deJcob/STM32_PBLV5/README.md

# STM32_PBLV5

In stm32_conn/Output there are electrical schematics of project.
