deJcob/STM32_PBLV5/stm32_conn/output/stm32_conn.pdf

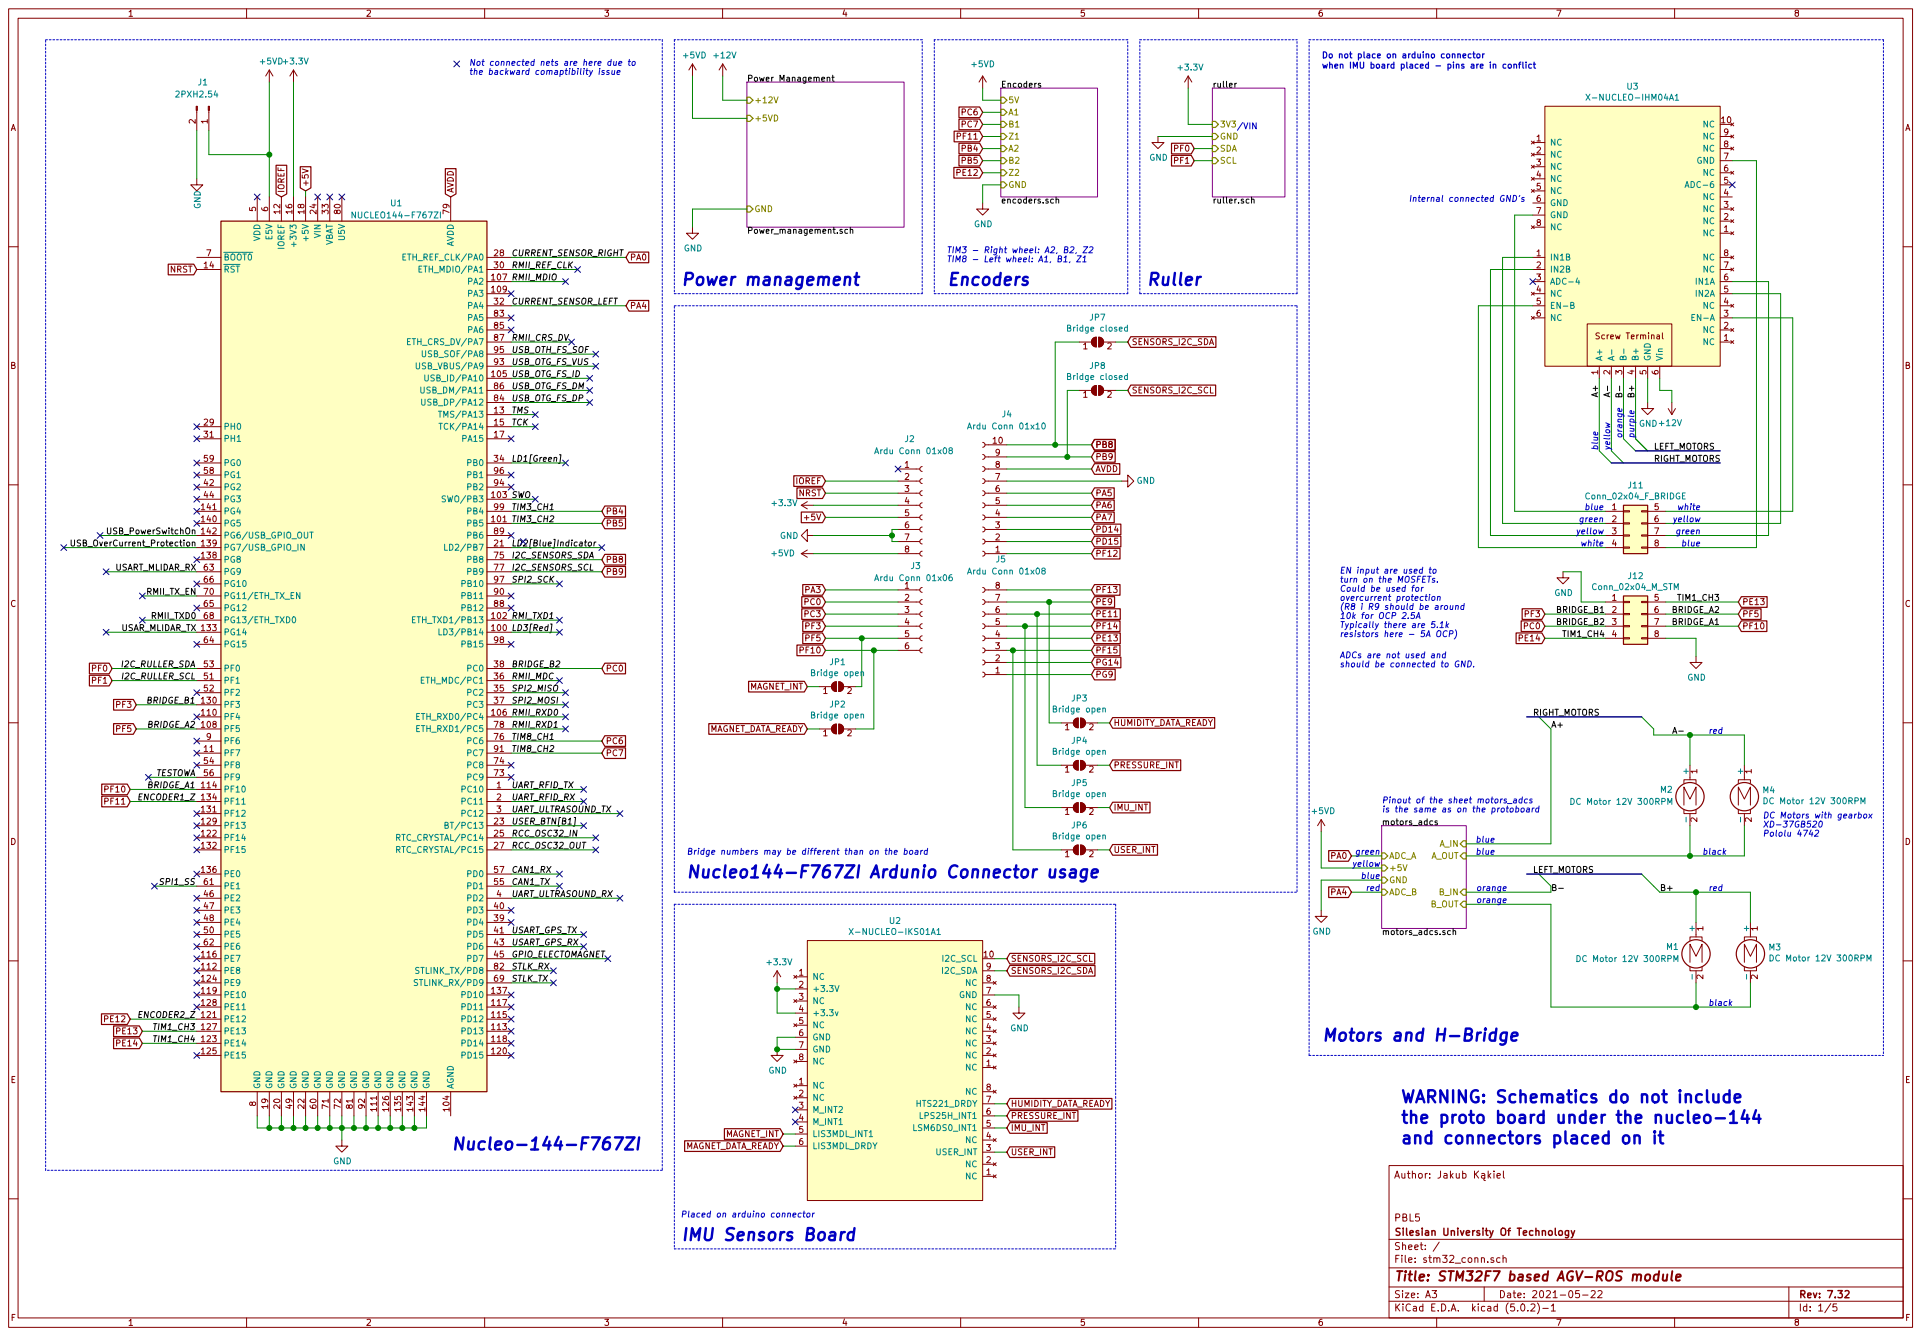
[picture p1: page 1]

the backward comaptibility issue

TIM3 - Right wheel: A2, B2, Z2 TIM8 - Left wheel: A1, B1, Z1
Encoders

turn on the MOSFETs. Could be used for overcurrent protection

(R8 i R9 should be around 10k for OCP 2.5A
Typically there are 5.1k
resistors here - 5A OCP) ADCs are not used and

Pinout of the sheet motors_adcs

DC Motors with gearbox XD-37GB520 Pololu 4742 IMU Sensors Board

Bridge numbers may be different than on the board

the proto board under the nucleo-144
and connectors placed on it

File: stm32_conn.sch Sheet: / Silesian University Of Technology PBL5 Author: Jakub Kkiel

Placed on arduino connector

Id: 1/5 Title: STM32F7 based AGV-ROS module

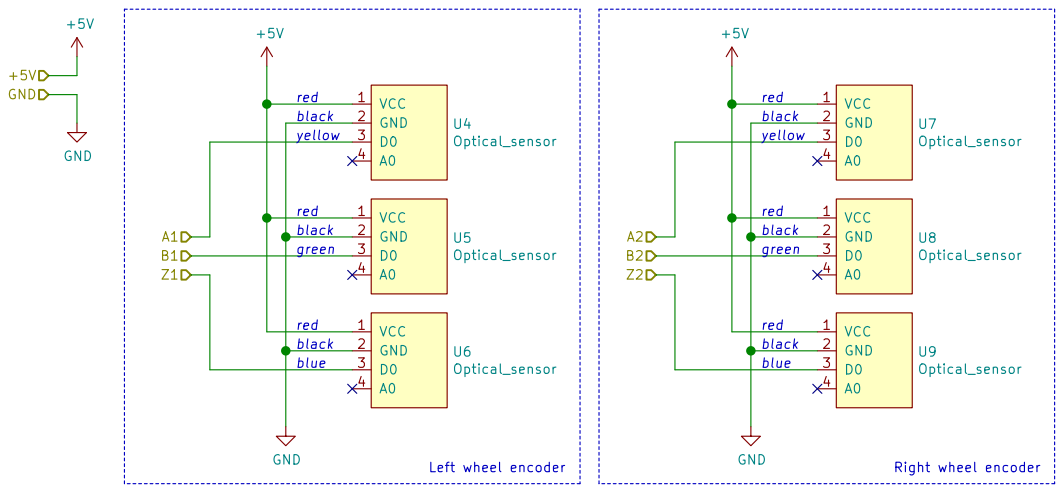
[picture p2: page 2]

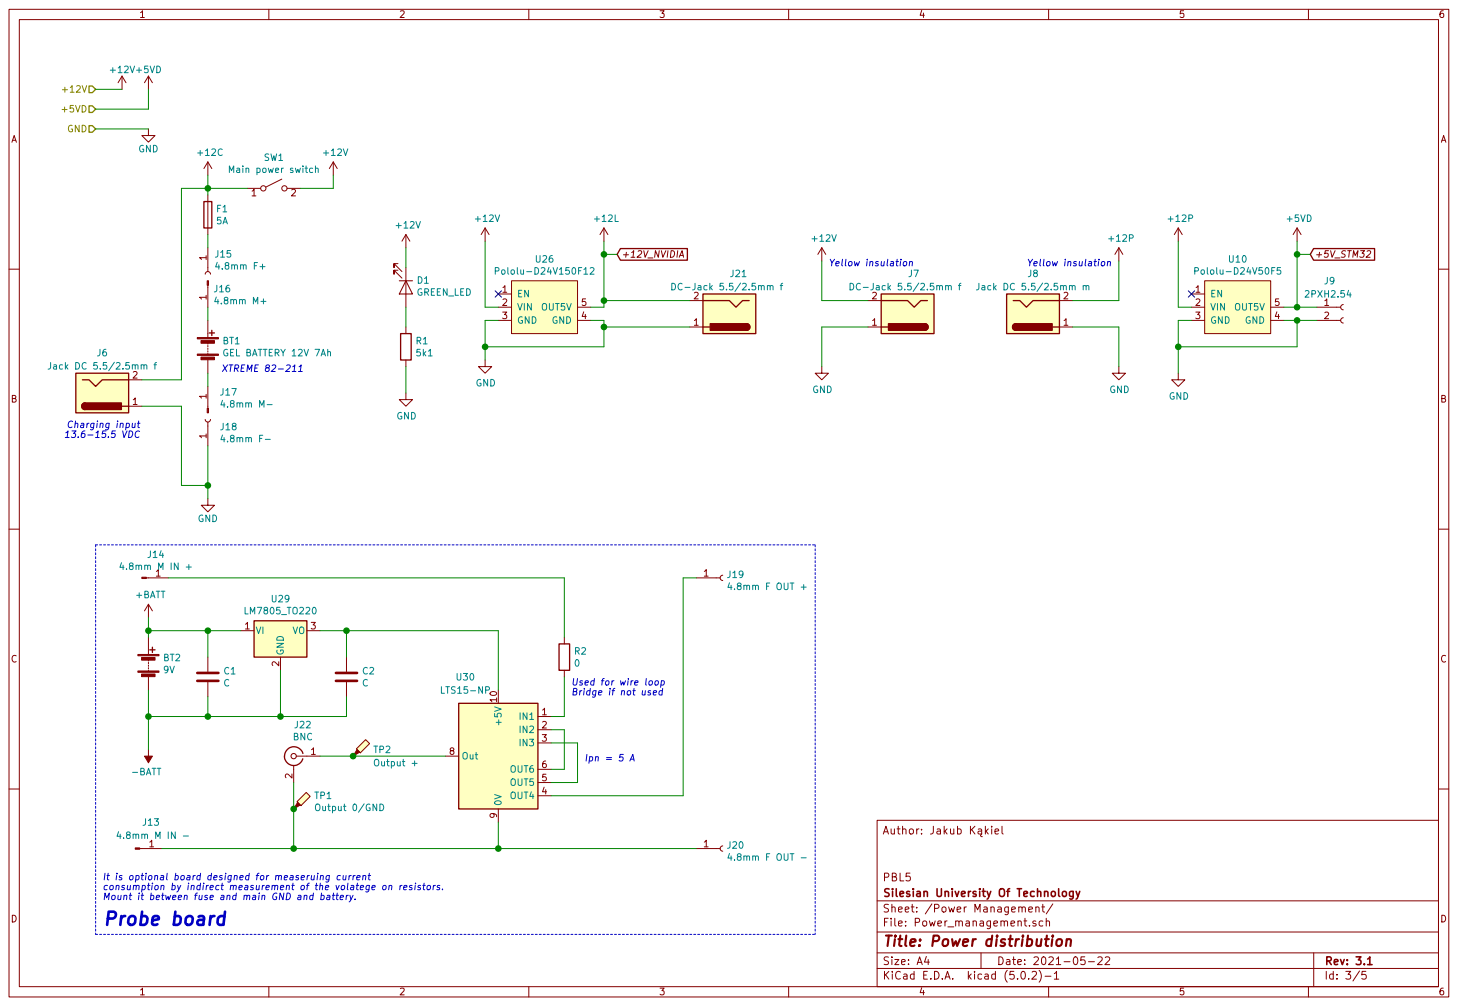
[picture p3: page 3]

Jack DC 5.5/2.5mm f Charging input 13.6-15.5 VDC

Bridge if not used

Silesian University Of Technology PBL5 Author: Jakub Kkiel

It is optional board designed for measeruing current
consumption by indirect measurement of the volatege on resistors.
Mount it between fuse and main GND and battery.

Sheet: /Power Management/
File: Power_management.sch
Id: 3/5 Title: Power distribution

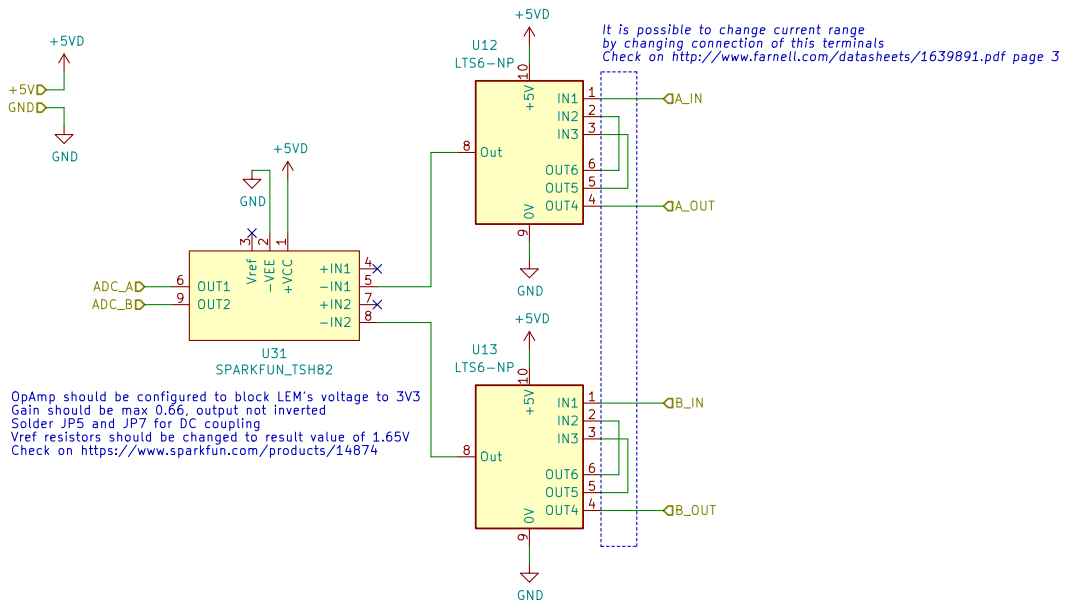
[picture p4: page 4]

It is possible to change current range
by changing connection of this terminals

Check on http://www.farnell.com/datasheets/1639891.pdf page 3 +VCC

Gain should be max 0.66, output not inverted
Solder JP5 and JP7 for DC coupling
Vref resistors should be changed to result value of 1.65V
Check on https://www.sparkfun.com/products/14874

Silesian University Of Technology PBL5 Author: Jakub Kkiel

Sheet: /motors_adcs/
File: motors_adcs.sch
Id: 4/5 Title: Motors ADC board

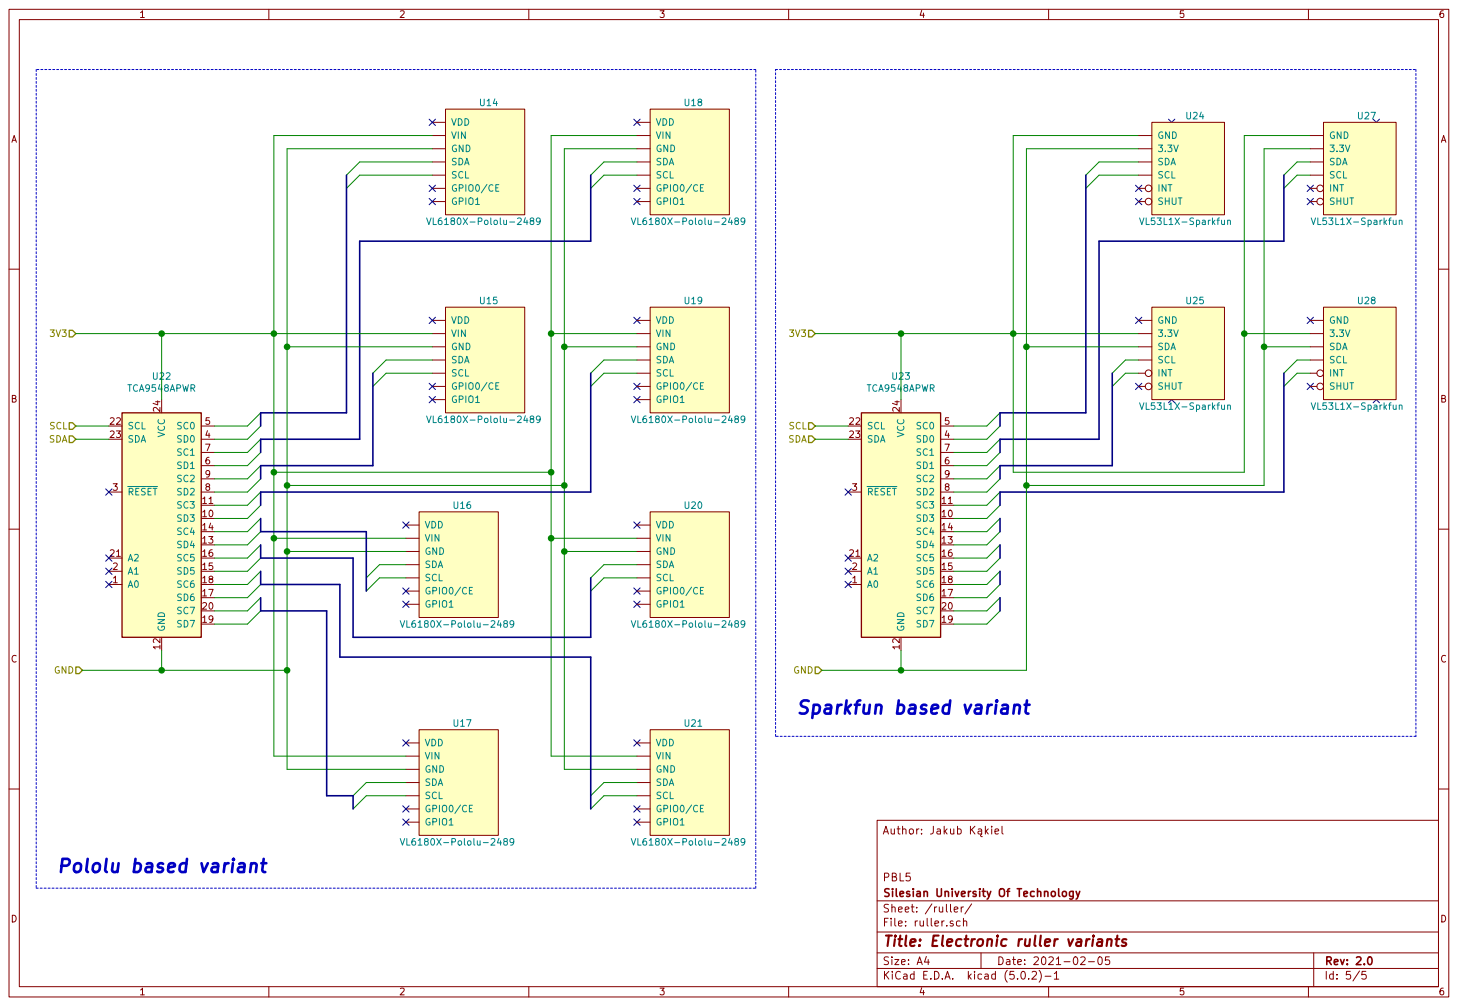
[picture p5: page 5]

U14 VL6180X-Pololu-2489 GND GPIO0/CE GPIO1 SCL SDA
VDD
VIN
GND GPIO0/CE GPIO1 SCL SDA
U15 VL6180X-Pololu-2489 GND GPIO0/CE GPIO1 SCL SDA
U20 VL6180X-Pololu-2489 GND GPIO0/CE GPIO1 SCL SDA

U18 VL6180X-Pololu-2489
U19 VL6180X-Pololu-2489 GND GPIO0/CE GPIO1 SCL SDA

SCL GND
U21 VL6180X-Pololu-2489 GND GPIO0/CE GPIO1 SCL SDA

U16 VL6180X-Pololu-2489 GND GPIO0/CE GPIO1 SCL SDA

File: ruller.sch Sheet: /ruller/ Silesian University Of Technology PBL5 Author: Jakub Kkiel

Id: 5/5 Title: Electronic ruller variants
