deJcob/STM32_PBLV5/PBLV5/Core/Src/main.cpp

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
/* Includes ------------------------------------------------------------------*/
#include "main.h"
#include "lwip.h"

/* USER CODE BEGIN Includes */

#include "EncoderSystem.h"
#include "DrivingSystem.h"
#include "IMUSensor.h"
#include "RulerSensor.h"
#include "DataPtrVolumePair.h"
#include "DataManagement.h"
#include "tcp_server.h"
#include "tcp_client.h"
#include "udp_client.h"
#include "TimerConfigurator.h"
#include "GPSManager.h"
#include "MiniLidarManager.h"
#include "TimeSync.h"
#include "CANLidar.h"
#include "RFIDManager.h"
#include "Electromagnet.h"
#include "TimeMeasurementSystem.h"
#include "UltrasoundManager.h"
#include "CurrentMeasurement.h"
#include "globalDefines.h"

extern "C" void UART_GPS_RX_PROCESSING(void);
extern "C" void UART_LIDAR_RX_PROCESSING(void);
extern "C" void UART_RFID_RX_PROCESSING(void);
extern "C" void UART_ULTRASOUND_RX_PROCESSING(void);

/* USER CODE END Includes */

/* USER CODE BEGIN PD */

#define UDP_CLIENT

/* USER CODE END PD */

ADC_HandleTypeDef hadc1;
DMA_HandleTypeDef hdma_adc1;

CAN_HandleTypeDef hcan1;

I2C_HandleTypeDef hi2c1;
I2C_HandleTypeDef hi2c2;

SPI_HandleTypeDef hspi2;

TIM_HandleTypeDef htim1;
TIM_HandleTypeDef htim3;
TIM_HandleTypeDef htim6;
TIM_HandleTypeDef htim7;
TIM_HandleTypeDef htim8;
TIM_HandleTypeDef htim9;
TIM_HandleTypeDef htim10;
TIM_HandleTypeDef htim11;
TIM_HandleTypeDef htim12;
TIM_HandleTypeDef htim13;
TIM_HandleTypeDef htim14;

UART_HandleTypeDef huart4;
UART_HandleTypeDef huart5;
UART_HandleTypeDef huart2;
UART_HandleTypeDef huart6;
DMA_HandleTypeDef hdma_uart4_rx;
DMA_HandleTypeDef hdma_uart5_rx;
DMA_HandleTypeDef hdma_usart2_rx;
DMA_HandleTypeDef hdma_usart6_rx;

PCD_HandleTypeDef hpcd_USB_OTG_FS;

/* USER CODE BEGIN PV */
EncoderSystem encoderSystem(&htim8, &htim3, ENCODER2_Z_Pin, ENCODER1_Z_Pin);
DrivingSystem drivingSystem(&htim1, TIM_CHANNEL_4, &htim1, TIM_CHANNEL_3);
IMUSensor imuSensors(IMU_NUM_OF_ELEM);
RulerSensor rulerSensors(RULER_SENSORS_COUNT);
DataManagement dataManagement;
TimerConfigurator timerConfig(&htim6, &htim9, &htim7);
GPSManager gpsManager(&hdma_usart2_rx);
MiniLidarManager miniLidarManager(&hdma_usart6_rx);
TimeSync timeSync;
CANLidar canLidar(&hcan1);
RFIDManager rfidManager(&hdma_uart4_rx);
Electromagnet electromagnet;
TimeMeasurementSystem timMeasureSystem(&htim14);
UltrasoundManager ultrasoundManager(&hdma_uart5_rx, &huart5);
CurrentMeasurement currentMeasurement(&hadc1, &hdma_adc1);

int16_t diffZOne = 0;
int16_t diffZTwo = 0;

int16_t diffZOneTimerValue = 0;
int16_t diffZTwoTimerValue = 0;

std::map<uint8_t, DataPtrVolumePair> dataPtrMap =
    {
        {ID_PWM, DataPtrVolumePair{1, SIZE_GET_PWM, std::bind(&DrivingSystem::getDataInArray, &drivingSystem, std::placeholders::_1)}},
        {ID_TIM, DataPtrVolumePair{1, SIZE_GET_TIM, std::bind(&TimerConfigurator::getDataInArray, &timerConfig, std::placeholders::_1)}},
        {ID_ACC, DataPtrVolumePair{IMU_NUM_OF_ELEM, SIZE_GET_ACC, std::bind(&IMUSensor::getAccData, &imuSensors, std::placeholders::_1)}},
        {ID_GYRO, DataPtrVolumePair{IMU_NUM_OF_ELEM, SIZE_GET_GYRO, std::bind(&IMUSensor::getGyroData, &imuSensors, std::placeholders::_1)}},
        {ID_MAG, DataPtrVolumePair{IMU_NUM_OF_ELEM, SIZE_GET_MAG, std::bind(&IMUSensor::getMagData, &imuSensors, std::placeholders::_1)}},
        {ID_RULER, DataPtrVolumePair{1, RULER_SENSORS_COUNT, std::bind(&RulerSensor::getPololuData, &rulerSensors, std::placeholders::_1)}},
        {ID_CURRENT, DataPtrVolumePair{CURRENT_NUM_OF_ELEM, SIZE_GET_CURRENT, std::bind(&CurrentMeasurement::getCurrentData, &currentMeasurement, std::placeholders::_1)}},
        {ID_ENCODER, DataPtrVolumePair{1, SIZE_GET_ENCODER, std::bind(&EncoderSystem::getDataInArray, &encoderSystem, std::placeholders::_1)}},
        {ID_GPS, DataPtrVolumePair{1, SIZE_GET_GPS, std::bind(&GPSManager::getDataInArray, &gpsManager, std::placeholders::_1)}},
        {ID_MINI_LIDAR, DataPtrVolumePair{1, SIZE_GET_MINI_LIDAR, std::bind(&MiniLidarManager::getDataInArray, &miniLidarManager, std::placeholders::_1)}},
        {ID_CAN_DIST, DataPtrVolumePair{1, SIZE_CAN_DIST, std::bind(&CANLidar::getDistanceDataInArray, &canLidar, std::placeholders::_1)}},
        {ID_CAN_SPEED, DataPtrVolumePair{1, SIZE_CAN_SPEED, std::bind(&CANLidar::getSpeedDataInArray, &canLidar, std::placeholders::_1)}},
        {ID_CAN_REFLE, DataPtrVolumePair{1, SIZE_CAN_REFLE, std::bind(&CANLidar::getReflectionDataInArray, &canLidar, std::placeholders::_1)}},
        {ID_RFID, DataPtrVolumePair{1, SIZE_RFID, std::bind(&RFIDManager::getDataInArray, &rfidManager, std::placeholders::_1)}},
        {ID_ULTRASOUND, DataPtrVolumePair{1, SIZE_GET_ULTRASOUND, std::bind(&UltrasoundManager::getDataInArray, &ultrasoundManager, std::placeholders::_1)}},
        {ID_TIM_MEASURE, DataPtrVolumePair{1, SIZE_GET_TIME_MEASURE, std::bind(&TimeMeasurementSystem::getDataInArray, &timMeasureSystem, std::placeholders::_1)}},
        {ID_PACKETS_INFO, DataPtrVolumePair{1, SIZE_GET_PACKETS_INFO, std::bind(&DataManagement::getPacketsInfo, &dataManagement, std::placeholders::_1)}},
        {ID_TIME_SYNC, DataPtrVolumePair{1, SIZE_GET_TIME_SYNC, std::bind(&TimeSync::getDataInArray, &timeSync, std::placeholders::_1)}}
    };
/* USER CODE END PV */

void SystemClock_Config(void);
static void MX_GPIO_Init(void);
static void MX_DMA_Init(void);
static void MX_TIM6_Init(void);
static void MX_TIM7_Init(void);
static void MX_TIM9_Init(void);
static void MX_TIM10_Init(void);
static void MX_TIM11_Init(void);
static void MX_CAN1_Init(void);
static void MX_I2C1_Init(void);
static void MX_SPI2_Init(void);
static void MX_TIM1_Init(void);
static void MX_TIM3_Init(void);
static void MX_TIM8_Init(void);
static void MX_TIM12_Init(void);
static void MX_TIM13_Init(void);
static void MX_TIM14_Init(void);
static void MX_UART4_Init(void);
static void MX_UART5_Init(void);
static void MX_USART2_UART_Init(void);
static void MX_USART6_UART_Init(void);
static void MX_USB_OTG_FS_PCD_Init(void);
static void MX_ADC1_Init(void);
static void MX_I2C2_Init(void);
/* USER CODE BEGIN 0 */

int _write(int file, char *ptr, int len)
{
  for (int i = 0; i < len; i++)
  {
    ITM_SendChar(*ptr++);
  }
  return len;
}

void HAL_TIM_PeriodElapsedCallback(TIM_HandleTypeDef *htim)
{
  if (htim->Instance == TIM7)
  {
    HAL_GPIO_TogglePin(LD2_GPIO_Port, LD2_Pin);
  }
  if (htim->Instance == TIM6)
  {
    timMeasureSystem.takeTS(0);
    imuSensors.pullDataFromSensorsI2C(&hi2c1);
    timMeasureSystem.calculateElapsedTime(0);

    rulerSensors.pullDataFromSensorsI2C(&hi2c2);
  }
  if (htim->Instance == TIM9)
  {
    timMeasureSystem.takeTS(1);

    uint16_t dataLength;
    std::unique_ptr<uint8_t[]> dataBuffer = std::make_unique<uint8_t[]>(dataManagement.getMaxDataSize());

    dataLength = dataManagement.getCollectedData(dataBuffer.get());

#ifdef UDP_CLIENT
    udp_client_send(dataBuffer.get(), dataLength);
#else
    sendDataWhileConnected(dataBuffer.get(), dataLength);
#endif

    timMeasureSystem.calculateElapsedTime(1);
  }
  if (htim->Instance == TIM10)
  {
    timMeasureSystem.takeTS(2);

    encoderSystem.encoderService();

    timMeasureSystem.calculateElapsedTime(2);
  }

  if (htim->Instance == TIM11)
  {
    timMeasureSystem.takeTS(3);

    drivingSystem.drivingService();

//
//    rulerSensors.pullDataFromSensorsI2C(&hi2c2);

    timMeasureSystem.calculateElapsedTime(3);
  }

  if (htim->Instance == TIM13)
  {
//    timMeasureSystem.takeTS(4);
//
////    canLidar.scheduleADASFrames();
//
//    timMeasureSystem.calculateElapsedTime(4);
  }

  if (htim->Instance == TIM12)
  {
//    timMeasureSystem.takeTS(5);
//
////    ultrasoundManager.fetchDistanceData();
//    rulerSensors.pullDataFromSensorsI2C(&hi2c2);
//    timMeasureSystem.takeTS(5);
  }

  if (htim->Instance == TIM14)
  {

    if (diffZOneTimerValue > 0)
    {
      //HAL_GPIO_TogglePin(LD1_GPIO_Port, LD1_Pin);
      diffZOneTimerValue--;
    }

    if (diffZTwoTimerValue > 0)
    {
      //HAL_GPIO_TogglePin(LD3_GPIO_Port, LD3_Pin);
      diffZTwoTimerValue--;
    }
  }
}

void UART_GPS_RX_PROCESSING(void)
{
  gpsManager.processRxData();
}

void UART_LIDAR_RX_PROCESSING()
{
  miniLidarManager.processRxData();
}

void UART_RFID_RX_PROCESSING(void)
{
  rfidManager.processRxData();
}

void UART_ULTRASOUND_RX_PROCESSING(void)
{
  ultrasoundManager.processRxData();
}

void HAL_UART_RxHalfCpltCallback(UART_HandleTypeDef *huart)
{
  if (huart->Instance == USART6)
  {
    miniLidarManager.processRxData();
  }

  if (huart->Instance == UART5)
  {
    ultrasoundManager.processRxData();
  }

  if (huart->Instance == USART2)
  {
    gpsManager.processRxData();
  }

  if (huart->Instance == UART4)
  {
    rfidManager.processRxData();
  }
}

void HAL_UART_RxCpltCallback(UART_HandleTypeDef *huart)
{
  if (huart->Instance == USART6)
  {
    miniLidarManager.processRxData();
  }

  if (huart->Instance == UART5)
  {
    ultrasoundManager.processRxData();
  }

  if (huart->Instance == USART2)
  {
    gpsManager.processRxData();
  }

  if (huart->Instance == UART4)
  {
    rfidManager.processRxData();
  }
}

void HAL_CAN_TxMailbox0CompleteCallback(CAN_HandleTypeDef *hcan)
{
  canLidar.sendCANFrames();
}

void HAL_CAN_TxMailbox1CompleteCallback(CAN_HandleTypeDef *hcan)
{
  canLidar.sendCANFrames();
}

void HAL_CAN_TxMailbox2CompleteCallback(CAN_HandleTypeDef *hcan)
{
  canLidar.sendCANFrames();
}

void HAL_CAN_RxFifo0MsgPendingCallback(CAN_HandleTypeDef *hcan)
{
  canLidar.processRXData(CAN_RX_FIFO0);
}

void HAL_CAN_RxFifo1MsgPendingCallback(CAN_HandleTypeDef *hcan)
{
  canLidar.processRXData(CAN_RX_FIFO1);
}
uint8_t imu[4];

void HAL_GPIO_EXTI_Callback(uint16_t GPIO_Pin)
{
  //encoderSystem.checkError(&GPIO_Pin);
}

/* USER CODE END 0 */

/**
  * @brief  The application entry point.
  * @retval int
  */
int main(void)
{
  /* MCU Configuration--------------------------------------------------------*/

  /* Reset of all peripherals, Initializes the Flash interface and the Systick. */
  HAL_Init();

  /* Configure the system clock */
  SystemClock_Config();

  /* Initialize all configured peripherals */
  MX_GPIO_Init();
  MX_DMA_Init();
  MX_TIM6_Init();
  MX_TIM7_Init();
  MX_TIM9_Init();
  MX_TIM10_Init();
  MX_TIM11_Init();
  MX_LWIP_Init();
  MX_CAN1_Init();
  MX_I2C1_Init();
  MX_SPI2_Init();
  MX_TIM1_Init();
  MX_TIM3_Init();
  MX_TIM8_Init();
  MX_TIM12_Init();
  MX_TIM13_Init();
  MX_TIM14_Init();
  MX_UART4_Init();
  MX_UART5_Init();
  MX_USART2_UART_Init();
  MX_USART6_UART_Init();
  MX_USB_OTG_FS_PCD_Init();
  MX_ADC1_Init();
  MX_I2C2_Init();
  /* USER CODE BEGIN 2 */

  HAL_ADC_Start_DMA(&hadc1, (uint32_t *)currentMeasurement.dataBuff, ADC_BUF_LEN);

  canLidar.configureCAN();

  HAL_UART_Receive_DMA(&huart2, gpsManager.getDataBuffer(), gpsManager.getBufferLength());
  HAL_UART_Receive_DMA(&huart6, miniLidarManager.getDataBuffer(), miniLidarManager.getBufferLength());
  HAL_UART_Receive_DMA(&huart4, rfidManager.getDataBuffer(), rfidManager.getBufferLength());
  HAL_UART_Receive_DMA(&huart5, ultrasoundManager.getDataBuffer(), ultrasoundManager.getBufferLength());

  HAL_I2C_Init(&hi2c1);
  HAL_I2C_Init(&hi2c2);
  imuSensors.initializeI2C_Sensors(&hi2c1);
  rulerSensors.initializeI2C_Sensors(&hi2c2);

  currentMeasurement.init();
  drivingSystem.initialize();

  dataManagement.configure(&dataPtrMap);
  tcp_server_init();

#ifdef UDP_CLIENT
  udp_client_connect();
#endif

  HAL_TIM_Base_Start(&htim14);
  HAL_TIM_Base_Start_IT(&htim6);
  HAL_TIM_Base_Start_IT(&htim7);
  HAL_TIM_Encoder_Start(&htim8, TIM_CHANNEL_ALL);
  HAL_TIM_Encoder_Start(&htim3, TIM_CHANNEL_ALL);
  HAL_TIM_Base_Start_IT(&htim10);
  HAL_CAN_Start(&hcan1);
  HAL_TIM_Base_Start_IT(&htim13);
  HAL_TIM_Base_Start(&htim12);
  HAL_TIM_Base_Start_IT(&htim9);
  HAL_TIM_PWM_Start(&htim1, TIM_CHANNEL_3);
  HAL_TIM_PWM_Start(&htim1, TIM_CHANNEL_4);
  HAL_TIM_Base_Start_IT(&htim11);

  /* USER CODE END 2 */

  /* Infinite loop */
  /* USER CODE BEGIN WHILE */
  while (1)
  {
    MX_LWIP_Process();

    /* USER CODE END WHILE */

    /* USER CODE BEGIN 3 */
  }
  /* USER CODE END 3 */
}

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
