deJcob/STM32_PBLV5/PBLV5/PBLV5.ioc

Mcu.UserName=STM32F767ZITx
PA0/WKUP.GPIO_Label=CURRENT_MEASUREMENT1
PA0/WKUP.Signal=ADCx_IN0
PA1.GPIO_Label=RMII_REF_CLK [LAN8742A-CZ-TR_REFCLK0]
PA1.Signal=ETH_REF_CLK
PA10.GPIO_Label=USB_ID
PA10.Signal=USB_OTG_FS_ID
PA11.GPIO_Label=USB_DM
PA11.Signal=USB_OTG_FS_DM
PA12.GPIO_Label=USB_DP
PA12.Signal=USB_OTG_FS_DP
PA13.GPIO_Label=TMS
PA13.Signal=SYS_JTMS-SWDIO
PA14.GPIO_Label=TCK
PA14.Signal=SYS_JTCK-SWCLK
PA2.GPIO_Label=RMII_MDIO [LAN8742A-CZ-TR_MDIO]
PA2.Signal=ETH_MDIO
PA4.GPIO_Label=CURRENT_MEASUREMENT2
PA4.Signal=ADCx_IN4
PA7.GPIO_Label=RMII_CRS_DV [LAN8742A-CZ-TR_CRS_DV]
PA7.Signal=ETH_CRS_DV
PA8.GPIO_Label=USB_SOF [TP1]
PA8.Signal=USB_OTG_FS_SOF
PA9.GPIO_Label=USB_VBUS
PA9.Signal=USB_OTG_FS_VBUS
PB0.GPIO_Label=LD1 [Green]
PB0.Signal=GPIO_Output
PB10.Signal=SPI2_SCK
PB13.GPIO_Label=RMII_TXD1 [LAN8742A-CZ-TR_TXD1]
PB13.Signal=ETH_TXD1
PB14.GPIO_Label=LD3 [Red]
PB14.Signal=GPIO_Output
PB3.GPIO_Label=SWO
PB3.Signal=SYS_JTDO-SWO
PB4.Signal=S_TIM3_CH1
PB5.Signal=S_TIM3_CH2
PB7.GPIO_Label=LD2 [Blue]
PB7.Signal=GPIO_Output
PB8.GPIO_Label=I2C_SENSOR_SCL
PB8.Signal=I2C1_SCL
PB9.GPIO_Label=I2C_SENSOR_SDA
PB9.Signal=I2C1_SDA
PC0.GPIO_Label=BRIDGE_B2
PC0.Signal=GPIO_Output
PC1.GPIO_Label=RMII_MDC [LAN8742A-CZ-TR_MDC]
PC1.Signal=ETH_MDC
PC10.GPIO_Label=UART_RFID_TX
PC10.Signal=UART4_TX
PC11.GPIO_Label=UART_RFID_RX
PC11.Signal=UART4_RX
PC12.GPIO_Label=UART_ULTRASOUND_TX
PC12.Signal=UART5_TX
PC13.GPIO_Label=USER_Btn [B1]
PC13.Signal=GPXTI13
PC14/OSC32_IN.Signal=RCC_OSC32_IN
PC15/OSC32_OUT.Signal=RCC_OSC32_OUT
PC2.Signal=SPI2_MISO
PC3.Signal=SPI2_MOSI
PC4.GPIO_Label=RMII_RXD0 [LAN8742A-CZ-TR_RXD0]
PC4.Signal=ETH_RXD0
PC5.GPIO_Label=RMII_RXD1 [LAN8742A-CZ-TR_RXD1]
PC5.Signal=ETH_RXD1
PC6.Signal=S_TIM8_CH1
PC7.Signal=S_TIM8_CH2
PD0.Signal=CAN1_RX
PD1.Signal=CAN1_TX
PD2.GPIO_Label=UART_ULTRASOUND_RX
PD2.Signal=UART5_RX
PD5.GPIO_Label=USART_GPS_TX
PD5.Signal=USART2_TX
PD6.GPIO_Label=USART_GPS_RX
PD6.Signal=USART2_RX
PD7.GPIO_Label=GPIO_ELECTROMAGNET
PD7.Signal=GPIO_Output
PD8.GPIO_Label=STLK_RX [STM32F103CBT6_PA3]
PD8.Signal=USART3_TX
PD9.GPIO_Label=STLK_TX [STM32F103CBT6_PA2]
PD9.Signal=USART3_RX
PE1.GPIO_Label=SPI1_SS
PE1.Signal=GPIO_Output
PE12.GPIO_Label=ENCODER2_Z
PE12.Signal=GPXTI12
PE13.Signal=S_TIM1_CH3
PE14.Signal=S_TIM1_CH4
PF0.GPIO_Label=I2C_RULLER_SDA
PF0.Signal=I2C2_SDA
PF1.GPIO_Label=I2C_RULLER_SCL
PF1.Signal=I2C2_SCL
PF10.GPIO_Label=BRIDGE_A1
PF10.Signal=GPIO_Output
PF11.GPIO_Label=ENCODER1_Z
PF11.Signal=GPXTI11
PF3.GPIO_Label=BRIDGE_B1
PF3.Signal=GPIO_Output
PF5.GPIO_Label=BRIDGE_A2
PF5.Signal=GPIO_Output
PF9.GPIO_Label=TESTOWA
PF9.Signal=GPIO_Output
PG11.GPIO_Label=RMII_TX_EN [LAN8742A-CZ-TR_TXEN]
PG11.Signal=ETH_TX_EN
PG13.GPIO_Label=RMII_TXD0 [LAN8742A-CZ-TR_TXD0]
PG13.Signal=ETH_TXD0
PG14.GPIO_Label=USART_MLIDAR_TX
PG14.Signal=USART6_TX
PG6.GPIO_Label=USB_PowerSwitchOn [STMPS2151STR_EN]
PG6.Signal=GPIO_Output
PG7.GPIO_Label=USB_OverCurrent [STMPS2151STR_FAULT]
PG7.Signal=GPIO_Input
PG9.GPIO_Label=USART_MLIDAR_RX
PG9.Signal=USART6_RX
PH0/OSC_IN.GPIO_Label=MCO [STM32F103CBT6_PA8]
PH0/OSC_IN.Signal=RCC_OSC_IN
PH1/OSC_OUT.Signal=RCC_OSC_OUT
