deJcob/STM32_PBLV5/PBLV5/Core/Inc/xNucleoShieldSensorsV3.h

/*
 * xNucleoShieldSensors.h
 *
 *  Created on: Aug 13, 2019
 *      Author: piotrek
 */

#ifndef XNUCLEOSHIELDSENSORSV3_H_
#define XNUCLEOSHIELDSENSORSV3_H_

#define XNucleoV3

#define LSM6DSO_GYRO_SENS_ADDR (0x6B << 1)
#define LSM6DSO_GYRO_CTRL_REG_2 0x11
#define LSM6DSO_GYRO_208HZ 0x50
#define LSM6DSO_GYRO_416HZ 0x60
#define LSM6DSO_GYRO_CTRL_REG_2_VALUE LSM6DSO_GYRO_416HZ
#define LSM6DSO_GYRO_DATA 0x22
#define LSM6DSO_GYRO_DATA_SIZE 6

#define LSM6DSO_ACC_SENS_ADDR (0x6B << 1)
#define LSM6DSO_ACC_CTRL_REG1 0x10
#define LSM6DSO_ACC_CTRL_208HZ 0x50
#define LSM6DSO_ACC_CTRL_416HZ 0x60
#define LSM6DSO_ACC_CTRL_REG1_VALUE LSM6DSO_ACC_CTRL_416HZ
#define LSM6DSO_ACC_DATA 0x28
#define LSM6DSO_ACC_DATA_SIZE 6

#define LSM6DSO_WHO_AM_I 0x0F

#define LIS2MDL_MAG_SENS_ADDR (0x1E << 1)
#define LIS2MDL_MAG_DATA 0x68
#define LIS2MDL_MAG_MULTI_READ 0x80
#define LIS2MDL_MAG_CFG_REG_A 0x60
#define LIS2MDL_MAG_50HZ 0x08
#define LIS2MDL_MAG_TEMP_COMP 0x80
#define LIS2MDL_MAG_CFG_REG_A_VALUE (LIS2MDL_MAG_50HZ | LIS2MDL_MAG_TEMP_COMP)
#define LIS2MDL_MAG_DATA_SIZE 6

#define LIS2MDL_WHO_AM_I 0x4F

#endif /* XNUCLEOSHIELDSENSORSV3_H_ */
