deJcob/STM32_PBLV5/PBLV5/Core/Src/udp_client.cpp

/**
  ******************************************************************************
  * @file    LwIP/LwIP_UDP_Client/Src/udp_client.c
  * @author  MCD Application Team
  * @brief   UDP client
  ******************************************************************************
  * @attention
  *
  * <h2><center>&copy; Copyright (c) 2017 STMicroelectronics International N.V. 
  * All rights reserved.</center></h2>
  *
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
  ******************************************************************************
  */
/* Includes ------------------------------------------------------------------*/
#include "main.h"
#include "lwip/pbuf.h"
#include "lwip/udp.h"
#include "lwip/tcp.h"
#include "DataManagement.h"

/* Private typedef -----------------------------------------------------------*/
/* Private define ------------------------------------------------------------*/

#define DEST_IP_ADDR0   (uint8_t) 172
#define DEST_IP_ADDR1   (uint8_t) 17
#define DEST_IP_ADDR2   (uint8_t) 10
#define DEST_IP_ADDR3   (uint8_t) 3

#define UDP_SERVER_PORT       (uint16_t) 1115

/* Private macro -------------------------------------------------------------*/
/* Private variables ---------------------------------------------------------*/
/* Private function prototypes -----------------------------------------------*/
void udp_receive_callback(void *arg, struct udp_pcb *upcb, struct pbuf *p, const ip_addr_t *addr, u16_t port);

struct udp_pcb *upcb;

extern DataManagement dataManagement;


/* Private functions ---------------------------------------------------------*/

/**
  * @brief  Connect to UDP server
  * @param  None
  * @retval None
  */
void udp_client_connect(void)
{
  ip_addr_t DestIPaddr;
  err_t err;
  
  /* Create a new UDP control block  */
  upcb = udp_new();
  
  if (upcb!=NULL)
  {
    /*assign destination IP address */
    IP4_ADDR( &DestIPaddr, DEST_IP_ADDR0, DEST_IP_ADDR1, DEST_IP_ADDR2, DEST_IP_ADDR3 );
    
    /* configure destination IP address and port */
    err= udp_connect(upcb, &DestIPaddr, UDP_SERVER_PORT);
    
    if (err == ERR_OK)
    {
      /* Set a receive callback for the upcb */
      udp_recv(upcb, udp_receive_callback, NULL);  
    }
  }
}

/**
  * @brief This function is called when an UDP datagrm has been received on the port UDP_PORT.
  * @param arg user supplied argument (udp_pcb.recv_arg)
  * @param pcb the udp_pcb which received data
  * @param p the packet buffer that was received
  * @param addr the remote IP address from which the packet was received
  * @param port the remote port from which the packet was received
  * @retval None
  */
void udp_client_send(uint8_t* dataToSend, uint16_t dataLength)
{
  struct pbuf *p;
  
  /* allocate pbuf from pool*/
  p = pbuf_alloc(PBUF_TRANSPORT, dataLength, PBUF_POOL);
  
  if (p != NULL)
  {
    /* copy data to pbuf */
    pbuf_take(p, dataToSend, dataLength);
    
    /* send udp data */
    if(udp_send(upcb, p) != ERR_OK)
    {
    	dataManagement.incrementFrameErrorCnt();
    }
    
    /* free pbuf */
    pbuf_free(p);
  }
}

/**
  * @brief This function is called when an UDP datagrm has been received on the port UDP_PORT.
  * @param arg user supplied argument (udp_pcb.recv_arg)
  * @param pcb the udp_pcb which received data
  * @param p the packet buffer that was received
  * @param addr the remote IP address from which the packet was received
  * @param port the remote port from which the packet was received
  * @retval None
  */
void udp_receive_callback(void *arg, struct udp_pcb *upcb, struct pbuf *p, const ip_addr_t *addr, u16_t port)
{
  /* Free receive pbuf */
  pbuf_free(p);
}

/************************ (C) COPYRIGHT STMicroelectronics *****END OF FILE****/
