deJcob/STM32_PBLV5/PBLV5/Core/Inc/unions.h

/*
 * unions.h
 *
 *  Created on: Jan 15, 2020
 *      Author: piotrek
 */

#ifndef UNIONS_H_
#define UNIONS_H_


union floatUnion
{
	float floatVal = 0;
	uint8_t arrVal[sizeof(float)];
};

union int32Union
{
	int32_t int32Val = 0;
	uint8_t arrVal[sizeof(uint32_t)];
};

#endif /* UNIONS_H_ */
