deJcob/STM32_PBLV5/(commit log)

2020-11-15 Init commit. Branch from https://github.com/PanAndrew/STM32_AMP
    [Power_management.sch, encoders.sch, stm32_conn.kicad_pcb, stm32_conn.sch]
2020-11-16 Updated electrical schematic: sensors bridges, gpios
    [stm32_conn.sch]
2020-11-23 Base version of STM32 code - working after porting from F4
2020-11-23 Added ADC and current sensors on schematic
    [Power_management.sch, encoders.sch, stm32_conn.sch]
2020-11-25 Added 8 pin connect for H-Bridge, updated colours of cables
    [Power_management.sch, encoders.sch, stm32_conn.sch]
2020-11-25 Colours of cables in encoders
    [encoders.sch]
2020-11-29 added additional encoder channel handling
2020-11-30 added z channel encoder handling
2020-12-02 Fixed timers prescaler
2020-12-02 Implemented TIM14 as timer responsible for visible representation of Z channels errors
    [PBLV5.ioc, main.cpp]
2020-12-14 Schematics cleanup
    [stm32_conn.sch]
2020-12-17 Changed enckoder pinout PE11 -> PF11 due to the pin collision with IKS01A3
    [stm32_conn.sch]
2020-12-17 Added rotation speed and rotation distance, timers settings upgraded. In this version speed on ROS has some peaks
2020-12-21 Implemented getting adc sensors values with DMA
2021-01-02 Schematics: added ADC board with correct pinout and colours of the wiring
    [Power_management.sch, encoders.sch, motors_adcs.sch, stm32_conn.sch]
2021-01-02 Added electronic ruller Cleanup, final version
    [Power_management.sch, encoders.sch, motors_adcs.sch, ruller.sch, stm32_conn.sch]
2021-01-02 Commented debug leds
2021-01-02 Updated ADC pinouts on schematics
    [stm32_conn.sch]
2021-01-02 Ruller pinout changed for more intuitive
    [ruller.sch, stm32_conn.sch]
2021-01-04 Jumpers from probe board deleted, added notes in polish
    [Power_management.sch]
2021-01-09 Changed ADC sampling rate due to the system blocking because of DMA
    - generater HAL files for ADC
    - deleted duplicated HAL_Init... calls
2021-01-14 Working on encoders
2021-01-16 Changed encoder's timers settings, implemented Savitzky-Golay filter
2021-01-17 Timers fixups, frequencies changed as in Piotr's project
    [PBLV5.ioc, main.cpp]
2021-01-18 Added dynamic change of speed filter
2021-01-20 Added interrup handler for Z signal with handling an error with value closest to current value
    [Encoder.h, EncoderSystem.cpp, EncoderSystem.h, main.cpp]
2021-02-02 added polulu sensor initializiation and getting data
2021-02-03 Updated power management scheamtic
    [Power_management.sch, stm32_conn.sch]
2021-02-03 Motors polarity fixed
2021-02-03 code cleanup and made reading from multiple sensors
2021-02-04 removed stub data from sending last sensor value and error code
    [RulerSensor.cpp]
2021-02-05 Updated ruler schematics. I2C expander added
    [ruller.sch]
2021-02-07 Changed probe board
    [Power_management.sch]
2021-02-10 Updated sensors and added i2c expander handling
2021-02-10 Added auto-restarting on specified errors, changed I2C from 100kHz to 400kHz
    [PBLV5.ioc, RulerSensor.cpp, RulerSensor.h, main.cpp]
2021-02-10 Added extended sensor configuration, including not ready device
2021-02-11 Removed sensor configuration controlling
2021-02-11 Fixup of RulerSensors, changed Stack size, added .vscode to gitignore
    [PBLV5.ioc, RulerSensor.cpp, RulerSensor.h, main.cpp]
2021-05-09 Schematics: Added OpAmp for current measurement
    [Power_management.sch, encoders.sch, motors_adcs.sch, ruller.sch, stm32_conn.sch]
2021-05-22 Added OpAmp for current measurement and changed current range to +-2A RMS
    [Power_management.sch, encoders.sch, motors_adcs.sch, ruller.sch, stm32_conn.sch]
2021-05-22 Schematics beatufing and cleaning, power management updated
    [Power_management.sch, motors_adcs.sch, stm32_conn.sch]
2021-05-22 Cable's colours added
    [stm32_conn.sch]
2021-05-30 Created current measurement class
2021-06-03 Added buffer for ADC DMA circular mode
2021-06-03 ADC frequency changed, now every channel is sampled with 13636 Hz
2021-06-05 ADC buffer class with needed handlers for DMA and UDP communication
2021-06-05 Added current measurement data to UDP communication
2021-06-16 Working version of data coping from DMA buffer to Ethernet buffer
2021-06-29 Revert "Decreased TIM6 period"
    This reverts commit 9750bc52ab36adb65ef756a754be670225372729.
    [PBLV5.ioc, main.cpp]
2021-06-29 Reverts, fixups, working version
    [RulerSensor.cpp, RulerSensor.h, main.cpp]
